Nitro-Mekatronik/Emulators_2024/Firmware/STM32F103/Emulators/ESL/BLE_UniEmulator_BMW_E60_E87_E90_5Ser/Note.txt

BMW Steering Lock Emulator

3-Series : BMW E60, BMW E61, BMW E62, BMW E63, BMW E64

5-Series : BMW E81, BMW E87, BMW E90, BMW E92, BMW E93

Mini Cooper : R55, R56
