Nitro-Mekatronik/Emulators_2024/Firmware/STM32F103/Emulators/ESL/BLE_UniEmulator_Chrysler/Note.txt

For CHRYSLER cars with Marquardt SCL (green connector) and SKREEM or WIN on board, 
designed by Daimler – Chrysler group and used on Voyager, 300, some Lancia etc…, 
usually up to 2011.

Test OK
