Nitro-Mekatronik/Emulators_2024/Firmware/STM32F103/Emulators/ESL/BLE_UniEmulator_BMW_E60_E87_E90_5Ser/Log/bmw e90 esl elv/fotograflar/WhatsApp Image 2021-02-11 at 14.41.08 (3).jpeg

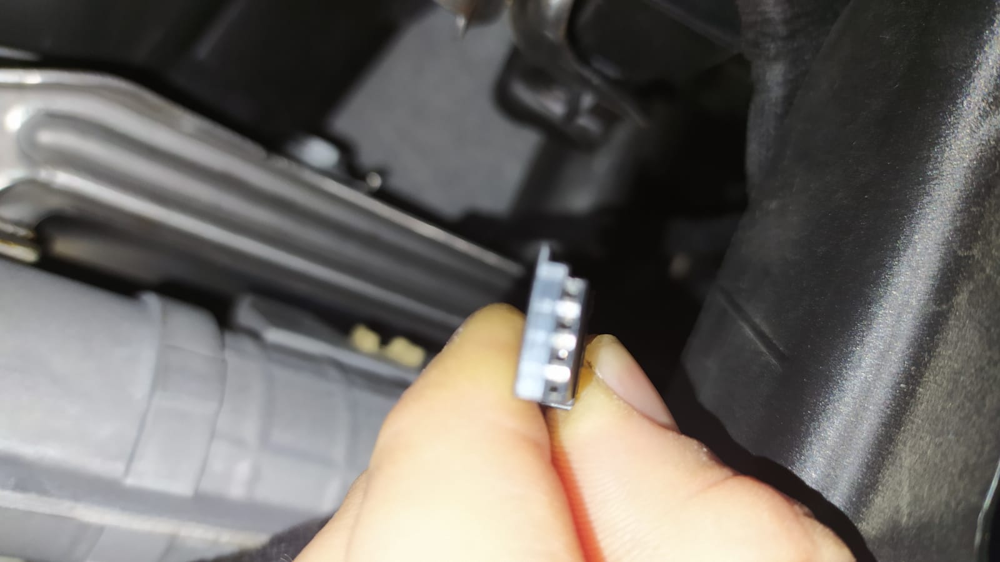
Firmware/STM32F103/Emulators/ESL/BLE_UniEmulator_BMW_E60_E87_E90_5Ser/Log/bmw e90 esl elv/fotograflar/WhatsApp Image 2021-02-11 at 14.41.08 (3).jpeg
