Nitro-Mekatronik/Emulators_2024/Firmware/STM32F103/Emulators/ESL/BLE_UniEmulator_Chrysler/Log/LIN Analyser.png

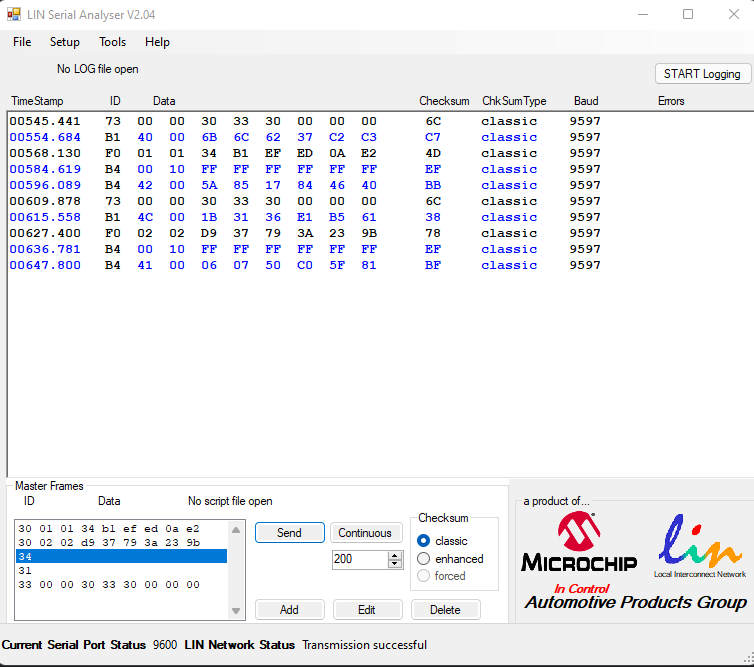
Firmware/STM32F103/Emulators/ESL/BLE_UniEmulator_Chrysler/Log/LIN Analyser.png
