Nitro-Mekatronik/Emulators_2024/Firmware/STM32F103/Emulators/ESL/BLE_UniEmulator_Volvo_S40/Log/Screenshot 2022-04-19 150752.png

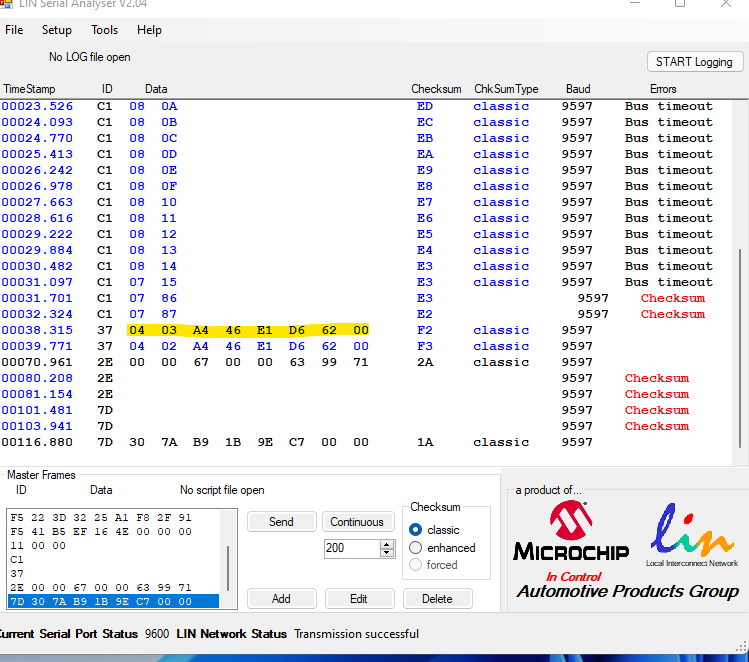
Firmware/STM32F103/Emulators/ESL/BLE_UniEmulator_Volvo_S40/Log/Screenshot 2022-04-19 150752.png
