Nitro-Mekatronik/Emulators_2024/Hardware/Arduino_Emulator New/Arduino_Emulator.xlsm

Ref | Qnty | Value | Footprint | Description | Vendor
C1, C2, C3, C10, C12, C13, C14, | 7 | 100nF 50V | C_0603 | Unpolarized capacitor, small symbol
C4, | 1 | 150pF 50V | C_0603 | Unpolarized capacitor, small symbol
C5, | 1 | 22uF 35V | C_1206 | Unpolarized capacitor, small symbol
C6, C9, | 2 | 22uF 10V | C_0805 | Unpolarized capacitor, small symbol
C7, | 1 | 10uF 10V | C_EIA-3216 | Polarized capacitor
D1, D4, | 2 | SS34 | D_SMA | Schottky diode, small symbol
D2, | 1 | LED | LED_0603 | Light emitting diode
D3, | 1 | SMAJ33A | D_SMA | Bidirectional transient-voltage-suppression diode
L1, L3, | 2 | 220R | L_0603 | Ferrite_Bead Inductor 220 Ohm @ 100MHz
L2, | 1 | CD32-100K | L_3.5mm_3mm | Inductor
R1, R7, | 2 | 10K | R_0603 | Resistor, small symbol
R2, | 1 | 5.1K | R_0603 | Resistor, small symbol
R3, | 1 | 27K | R_0603 | Resistor, small symbol
R4, | 1 | 1K | R_0603 | Resistor, small symbol
R5, | 1 | 120R | R_0805 | Resistor, small symbol
R6, | 1 | 0R | R_0603 | Resistor, small symbol
R8, R10, | 2 | 100K | R_0603 | Resistor, small symbol
R9, | 1 | 200K | R_0603 | Resistor, small symbol
U1, | 1 | ATmega328P-AU | TQFP-32_7x7mm_P0.8mm
U2, | 1 | MCP2515 | SOIC-18W_7.5x11.6mm_P1.27mm
U3, | 1 | MP2467 | TI_SO-PowerPAD-8
U4, | 1 | TJA1050T | SOIC-8_3.9x4.9mm_P1.27mm | High-Speed CAN Transceiver, silent mode, SOIC-8
Y1, Y2, | 2 | 8MHZ | Resonator_SMD_muRata_CSTxExxV-3Pin_3.0x1.1mm | Three pin crystal, GND on pin 2
