Nitro-Mekatronik/Emulators_2024/Hardware/NTR-MAIN-U2xx/NTR-MAIN-U2xx.kicad_pcb

## KiCad design Hardware/NTR-MAIN-U2xx/NTR-MAIN-U2xx.kicad_pcb (2025-08-07)

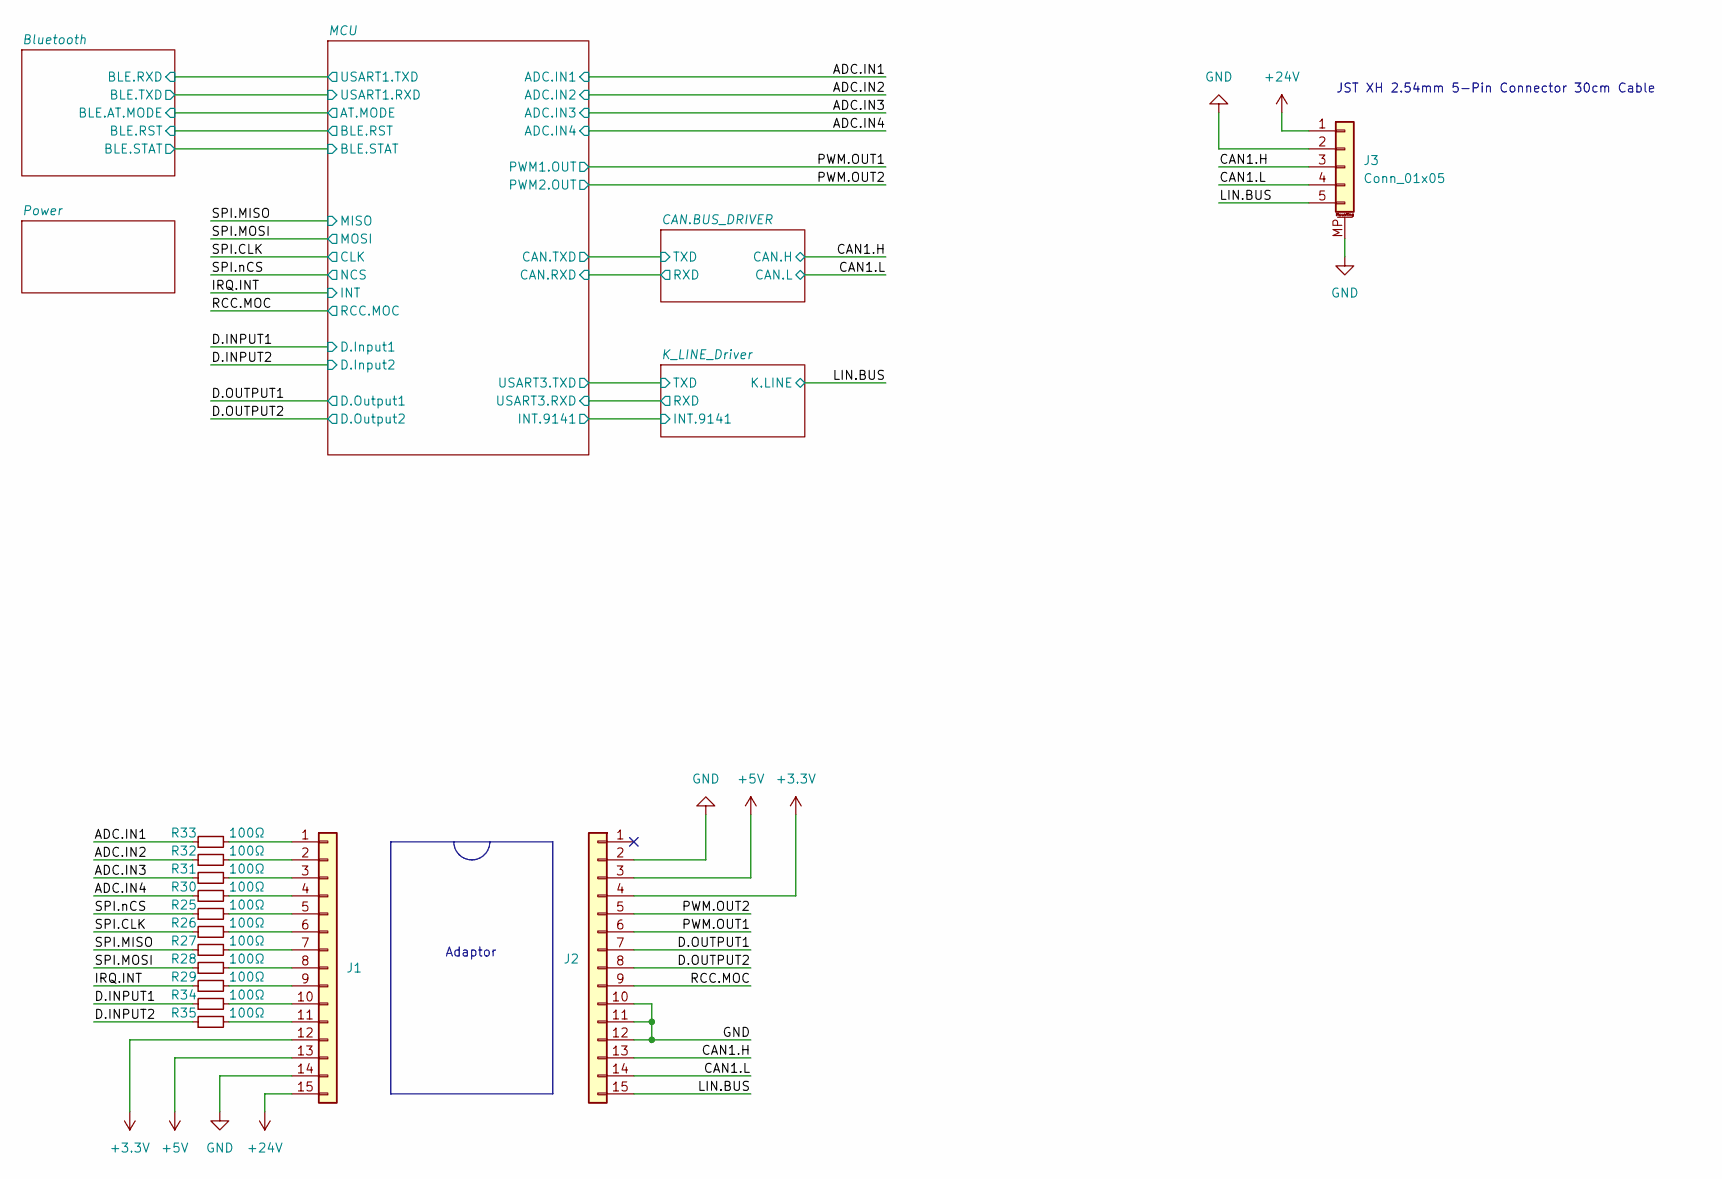
[picture p9: schematic NTR-MAIN-U2xx.kicad_sch]

Parts:
J1, J2: Conn_01x15; PinSocket_1x15_P2.54mm_Vertical; LCSC C2897378
J3: Conn_01x05; Molex_PicoBlade_53261-0571_1x05-1MP_P1.25mm_Horizontal; LCSC C481427
R25, R26, R27, R28, R29, R30, R31, R32, R33, R34, R35: 100Ω; R_0402_1005Metric; LCSC C25076

Connections:
+3.3V: J1.12, J2.4; also elsewhere on the board
+5V: J1.13, J2.3; also elsewhere on the board
+24V: J1.15, J3.1; also elsewhere on the board
/ADC.IN1: R33.1; also elsewhere on the board
/ADC.IN2: R32.1; also elsewhere on the board
/ADC.IN3: R31.1; also elsewhere on the board
/ADC.IN4: R30.1; also elsewhere on the board
/CAN1.H: J2.13, J3.3; also elsewhere on the board
/CAN1.L: J2.14, J3.4; also elsewhere on the board
/D.INPUT1: R34.1; also elsewhere on the board
/D.INPUT2: R35.1; also elsewhere on the board
/D.OUTPUT1: J2.7; also elsewhere on the board
/D.OUTPUT2: J2.8; also elsewhere on the board
/IRQ.INT: R29.1; also elsewhere on the board
/LIN.BUS: J2.15, J3.5; also elsewhere on the board
/PWM.OUT1: J2.6; also elsewhere on the board
/PWM.OUT2: J2.5; also elsewhere on the board
/RCC.MOC: J2.9; also elsewhere on the board
/SPI.CLK: R26.1; also elsewhere on the board
/SPI.MISO: R27.1; also elsewhere on the board
/SPI.MOSI: R28.1; also elsewhere on the board
/SPI.nCS: R25.1; also elsewhere on the board
GND: J1.14, J2.2, J2.10, J2.11, J2.12, J3.2, J3.MP (MountPin); also elsewhere on the board
unnamed: J1.1, R33.2
unnamed: J1.2, R32.2
unnamed: J1.3, R31.2
unnamed: J1.4, R30.2
unnamed: J1.5, R25.2
unnamed: J1.6, R26.2
unnamed: J1.7, R27.2
unnamed: J1.8, R28.2
unnamed: J1.9, R29.2
unnamed: J1.10, R34.2
unnamed: J1.11, R35.2

Notes on the sheet:
Adaptor
JST XH 2.54mm 5-Pin Connector 30cm Cable

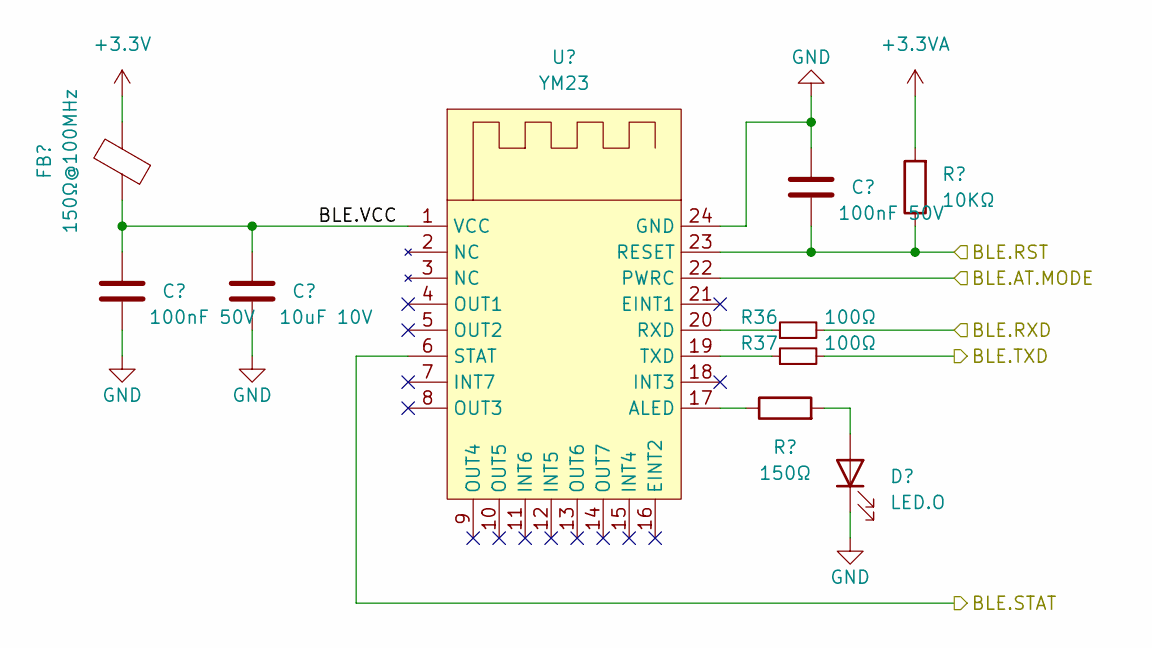
[picture p10: schematic Bluetooth.kicad_sch]

Parts:
C8, C10: 100nF 50V; C_0402_1005Metric; LCSC C77020
C9: 10uF 10V; C_0402_1005Metric; LCSC C315248
D4: LED.O; LED_0402_1005Metric; LCSC C434447
FB1: 150Ω@100MHz; L_0402_1005Metric; LCSC C160612
R15: 150Ω; R_0402_1005Metric; LCSC C25082
R16: 10KΩ; R_0402_1005Metric; LCSC C25744
R36, R37: 100Ω; R_0402_1005Metric; LCSC C25076
U4: YM23; JDY-08; LCSC C2905738

Connections:
+3.3V: FB1.2; also elsewhere on the board
+3.3VA: R16.2; also elsewhere on the board
/Bluetooth/BLE.AT.MODE: U4.22 (PWRC); also elsewhere on the board
/Bluetooth/BLE.RST: C10.2, R16.1, U4.23 (RESET); also elsewhere on the board
/Bluetooth/BLE.RXD: R36.2; also elsewhere on the board
/Bluetooth/BLE.STAT: U4.6 (STAT); also elsewhere on the board
/Bluetooth/BLE.TXD: R37.2; also elsewhere on the board
/Bluetooth/BLE.VCC: C8.1, C9.1, FB1.1, U4.1 (VCC)
GND: C8.2, C9.2, C10.1, D4.1 (K), U4.24 (GND); also elsewhere on the board
unnamed: D4.2 (A), R15.2
unnamed: R15.1, U4.17 (ALED)
unnamed: R36.1, U4.20 (RXD)
unnamed: R37.1, U4.19 (TXD)

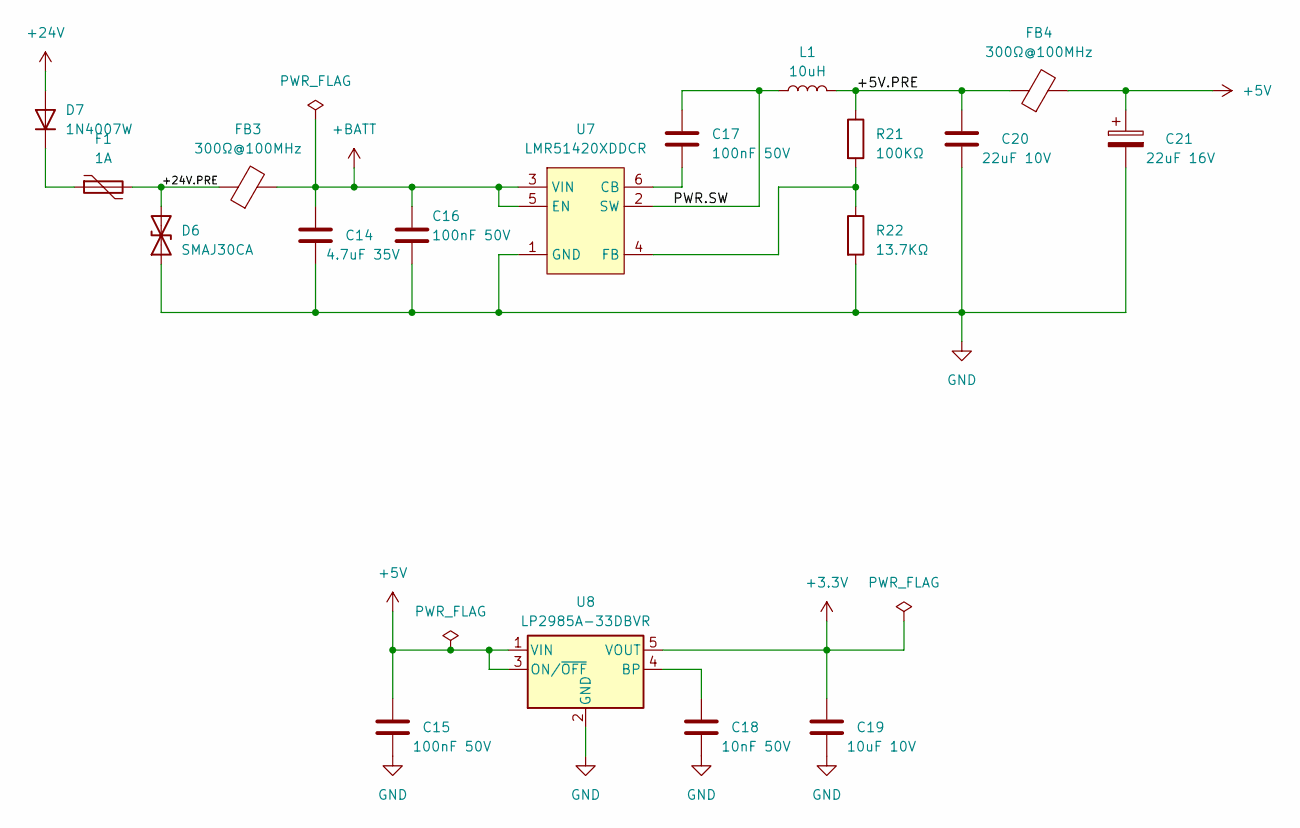
[picture p11: schematic Power.kicad_sch]

Parts:
C14: 4.7uF 35V; C_0603_1608Metric; LCSC C162274
C15, C16, C17: 100nF 50V; C_0402_1005Metric; LCSC C77020
C18: 10nF 50V; C_0402_1005Metric; LCSC C15195
C19: 10uF 10V; C_0402_1005Metric; LCSC C315248
C20: 22uF 10V; C_0805_2012Metric; LCSC C380336
C21: 22uF 16V; CP_EIA-3216-10_Kemet-I; LCSC C782264
D6: SMAJ30CA; D_SMA; LCSC C356367
D7: 1N4007W; D_SOD-123; LCSC C3018540
F1: 1A; Fuse_1812_4532Metric; LCSC C782762
FB3: 300Ω@100MHz; L_0603_1608Metric; LCSC C401489
FB4: 300Ω@100MHz; L_0805_2012Metric; LCSC C67451
L1: 10uH; L_Bourns-SRN4018; LCSC C135244
R21: 100KΩ; R_0402_1005Metric; LCSC C25741
R22: 13.7KΩ; R_0402_1005Metric; LCSC C25854
U7: LMR51420XDDCR; SOT-23-6; LCSC C5246146
U8: LP2985A-33DBVR; SOT-23-5; LCSC C89826

Connections:
+3.3V: C19.1, U8.5 (VOUT); also elsewhere on the board
+5V: C15.1, C21.1, FB4.2, U8.1 (VIN), U8.3 (ON/~OFF); also elsewhere on the board
+24V: D7.2 (A); also elsewhere on the board
+BATT: C14.1, C16.1, FB3.2, U7.3 (VIN), U7.5 (EN); also elsewhere on the board
/Power/+5V.PRE: C20.1, FB4.1, L1.2, R21.1
/Power/+24V.PRE: D6.2 (A2), F1.2, FB3.1
/Power/PWR.SW: C17.1, L1.1, U7.2 (SW)
GND: C14.2, C15.2, C16.2, C18.2, C19.2, C20.2, C21.2, D6.1 (A1), R22.2, U7.1 (GND), U8.2 (GND); also elsewhere on the board
unnamed: D7.1 (K), F1.1
unnamed: C17.2, U7.6 (CB)
unnamed: R21.2, R22.1, U7.4 (FB)
unnamed: C18.1, U8.4 (BP)

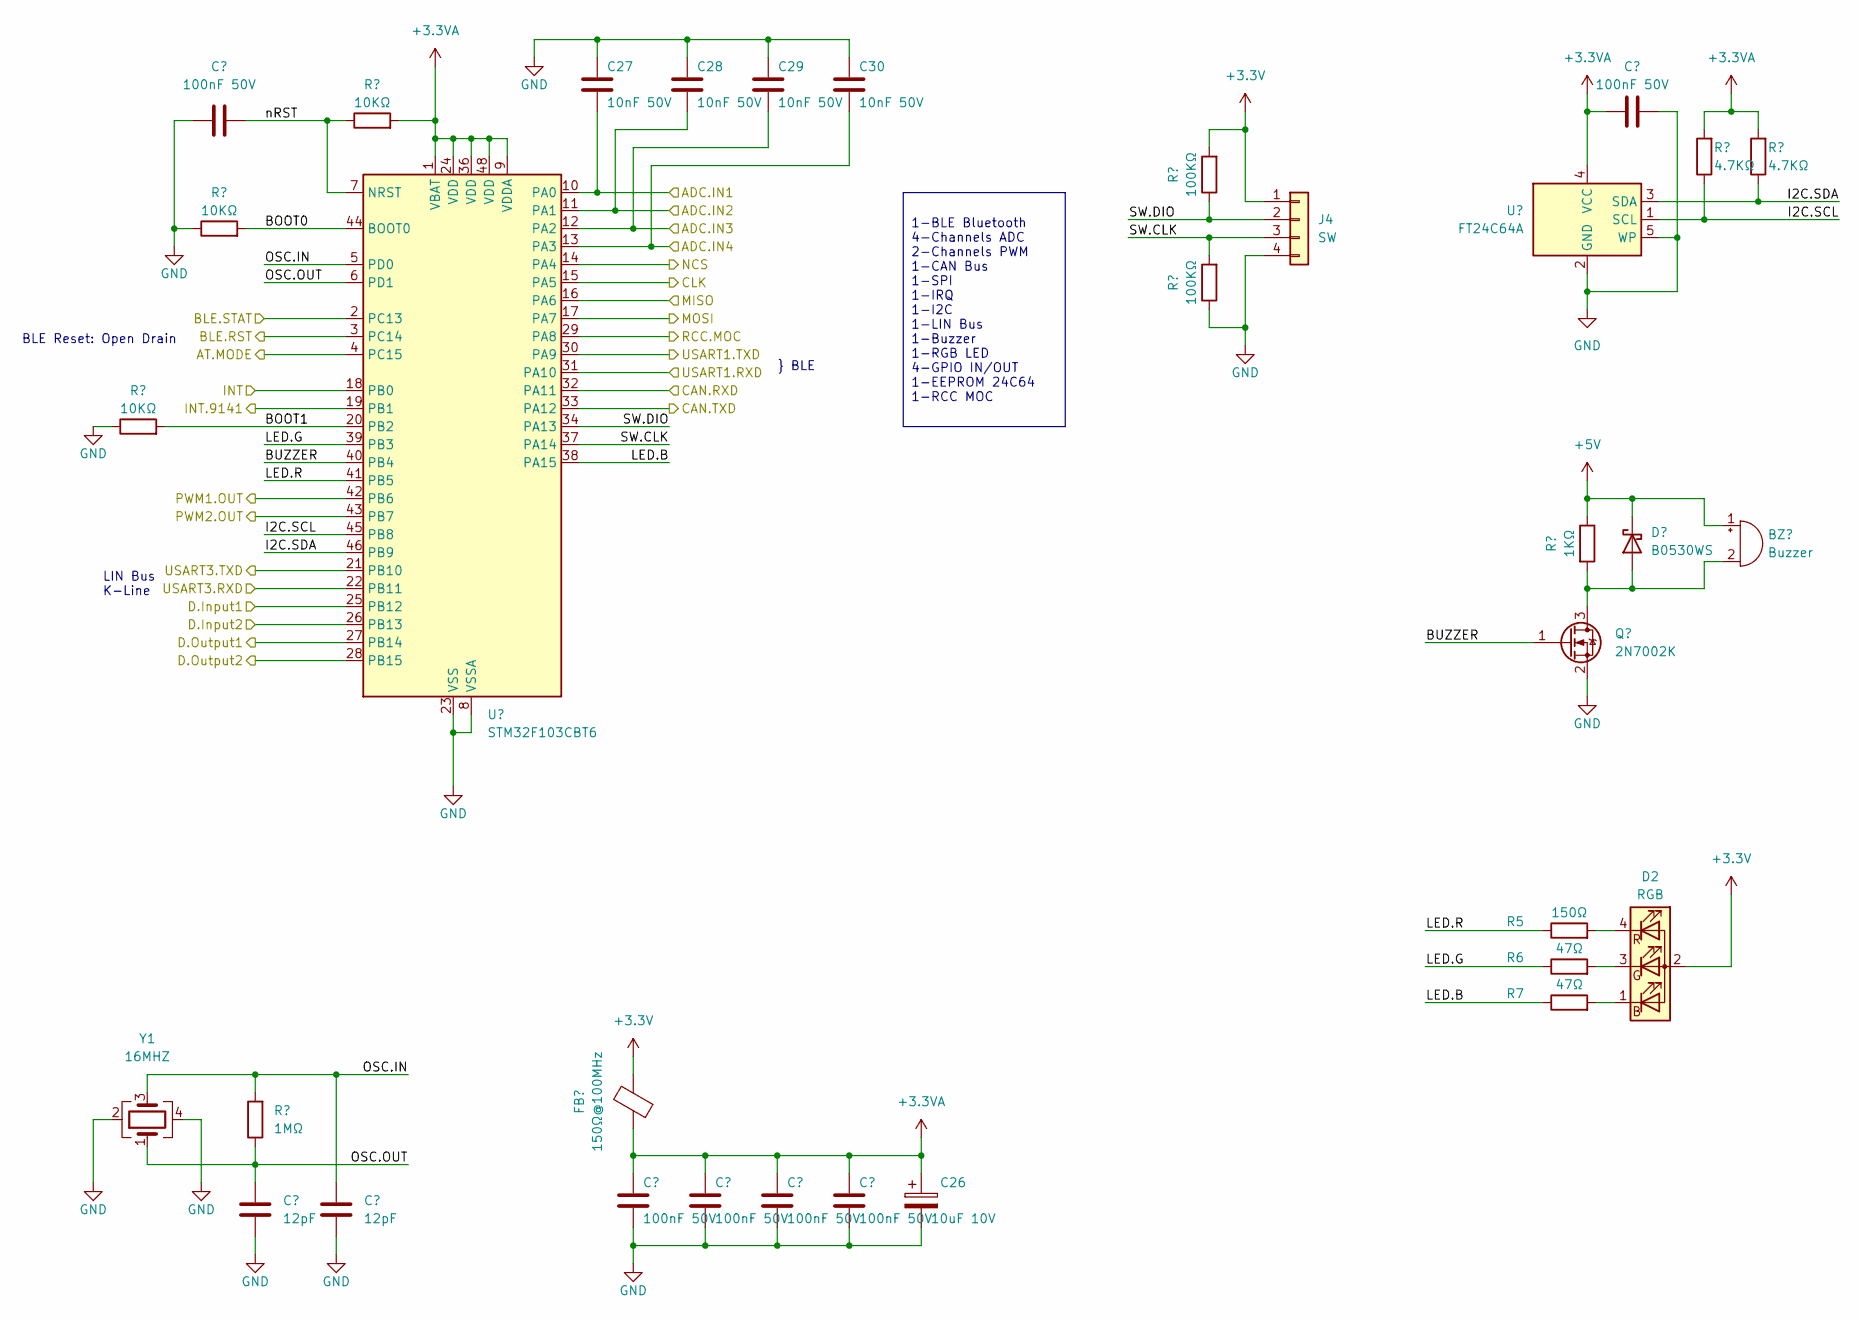
[picture p12: schematic mcu.kicad_sch]

Parts:
BZ1: Buzzer; MagneticBuzzer_CUI_CMT-8504-100-SMT; LCSC C255315
C1, C4, C22, C23, C24, C25: 100nF 50V; C_0402_1005Metric; LCSC C77020
C2, C3: 12pF; C_0402_1005Metric; LCSC C76948
C26: 10uF 10V; CP_EIA-3216-10_Kemet-I; LCSC C7177
C27, C28, C29, C30: 10nF 50V; C_0402_1005Metric; LCSC C15195
D1: B0530WS; D_SOD-323; LCSC C2961213
D2: RGB; LED_Cree-PLCC4_2x2mm_CW; LCSC C375569
FB5: 150Ω@100MHz; L_0402_1005Metric; LCSC C160612
J4: SW; PinHeader_1x04_P2.54mm_Vertical
Q1: 2N7002K; SOT-23; LCSC C2848187
R1, R2, R4: 10KΩ; R_0402_1005Metric; LCSC C25744
R3: 1MΩ; R_0402_1005Metric; LCSC C138033
R5: 150Ω; R_0402_1005Metric; LCSC C25082
R6, R7: 47Ω; R_0402_1005Metric; LCSC C25168
R8: 1KΩ; R_0402_1005Metric; LCSC C11702
R9, R10: 4.7KΩ; R_0402_1005Metric; LCSC C25900
R23, R24: 100KΩ; R_0402_1005Metric; LCSC C25741
U1: STM32F103CBT6; LQFP-48_7x7mm_P0.5mm; LCSC C8304
U2: FT24C64A; SOT-23-5; LCSC C5263778
Y1: 16MHZ; Crystal_SMD_2520-4Pin_2.5x2.0mm; LCSC C13738

Connections:
+3.3V: D2.2 (A), FB5.2, J4.1, R23.2; also elsewhere on the board
+3.3VA: C4.1, C22.2, C23.2, C24.2, C25.2, C26.1, FB5.1, R4.2, R9.2, R10.2, U1.1 (VBAT), U1.9 (VDDA), U1.24 (VDD), U1.36 (VDD), U1.48 (VDD), U2.4 (VCC); also elsewhere on the board
+5V: BZ1.1 (-), D1.1 (K), R8.1; also elsewhere on the board
/ADC.IN1: C27.2, U1.10 (PA0); also elsewhere on the board
/ADC.IN2: C28.2, U1.11 (PA1); also elsewhere on the board
/ADC.IN3: C29.2, U1.12 (PA2); also elsewhere on the board
/ADC.IN4: C30.2, U1.13 (PA3); also elsewhere on the board
/Bluetooth/BLE.AT.MODE: U1.4 (PC15); also elsewhere on the board
/Bluetooth/BLE.RST: U1.3 (PC14); also elsewhere on the board
/Bluetooth/BLE.RXD: U1.30 (PA9); also elsewhere on the board
/Bluetooth/BLE.STAT: U1.2 (PC13); also elsewhere on the board
/Bluetooth/BLE.TXD: U1.31 (PA10); also elsewhere on the board
/CAN.BUS_DRIVER/RXD: U1.32 (PA11); also elsewhere on the board
/CAN.BUS_DRIVER/TXD: U1.33 (PA12); also elsewhere on the board
/D.INPUT1: U1.25 (PB12); also elsewhere on the board
/D.INPUT2: U1.26 (PB13); also elsewhere on the board
/D.OUTPUT1: U1.27 (PB14); also elsewhere on the board
/D.OUTPUT2: U1.28 (PB15); also elsewhere on the board
/IRQ.INT: U1.18 (PB0); also elsewhere on the board
/K_LINE_Driver/INT.9141: U1.19 (PB1); also elsewhere on the board
/K_LINE_Driver/RXD: U1.22 (PB11); also elsewhere on the board
/K_LINE_Driver/TXD: U1.21 (PB10); also elsewhere on the board
/MCU/BOOT0: R2.2, U1.44 (BOOT0)
/MCU/BOOT1: R1.2, U1.20 (PB2)
/MCU/BUZZER: Q1.1 (G), U1.40 (PB4)
/MCU/I2C.SCL: R9.1, U1.45 (PB8), U2.1 (SCL)
/MCU/I2C.SDA: R10.1, U1.46 (PB9), U2.3 (SDA)
/MCU/LED.B: R7.1, U1.38 (PA15)
/MCU/LED.G: R6.1, U1.39 (PB3)
/MCU/LED.R: R5.1, U1.41 (PB5)
/MCU/OSC.IN: C3.1, R3.2, U1.5 (PD0), Y1.3
/MCU/OSC.OUT: C2.1, R3.1, U1.6 (PD1), Y1.1
/MCU/SW.CLK: J4.3, R24.2, U1.37 (PA14)
/MCU/SW.DIO: J4.2, R23.1, U1.34 (PA13)
/MCU/nRST: C1.2, R4.1, U1.7 (NRST)
/PWM.OUT1: U1.42 (PB6); also elsewhere on the board
/PWM.OUT2: U1.43 (PB7); also elsewhere on the board
/RCC.MOC: U1.29 (PA8); also elsewhere on the board
/SPI.CLK: U1.15 (PA5); also elsewhere on the board
/SPI.MISO: U1.16 (PA6); also elsewhere on the board
/SPI.MOSI: U1.17 (PA7); also elsewhere on the board
/SPI.nCS: U1.14 (PA4); also elsewhere on the board
GND: C1.1, C2.2, C3.2, C4.2, C22.1, C23.1, C24.1, C25.1, C26.2, C27.1, C28.1, C29.1, C30.1, J4.4, Q1.2 (S), R1.1, R2.1, R24.1, U1.8 (VSSA), U1.23 (VSS), U1.35 (VSS), U1.47 (VSS), U2.2 (GND), U2.5 (WP), Y1.2, Y1.4; also elsewhere on the board
unnamed: BZ1.2 (+), D1.2 (A), Q1.3 (D), R8.2
unnamed: D2.1 (BK), R7.2
unnamed: D2.3 (GK), R6.2
unnamed: D2.4 (RK), R5.2

Notes on the sheet:
1-BLE Bluetooth 4-Channels ADC 2-Channels PWM 1-CAN Bus 1-SPI 1-IRQ 1-I2C 1-LIN Bus 1-Buzzer 1-RGB LED 4-GPIO IN/OUT 1-EEPROM 24C64 1-RCC MOC
LIN Bus K-Line
BLE Reset: Open Drain
} BLE

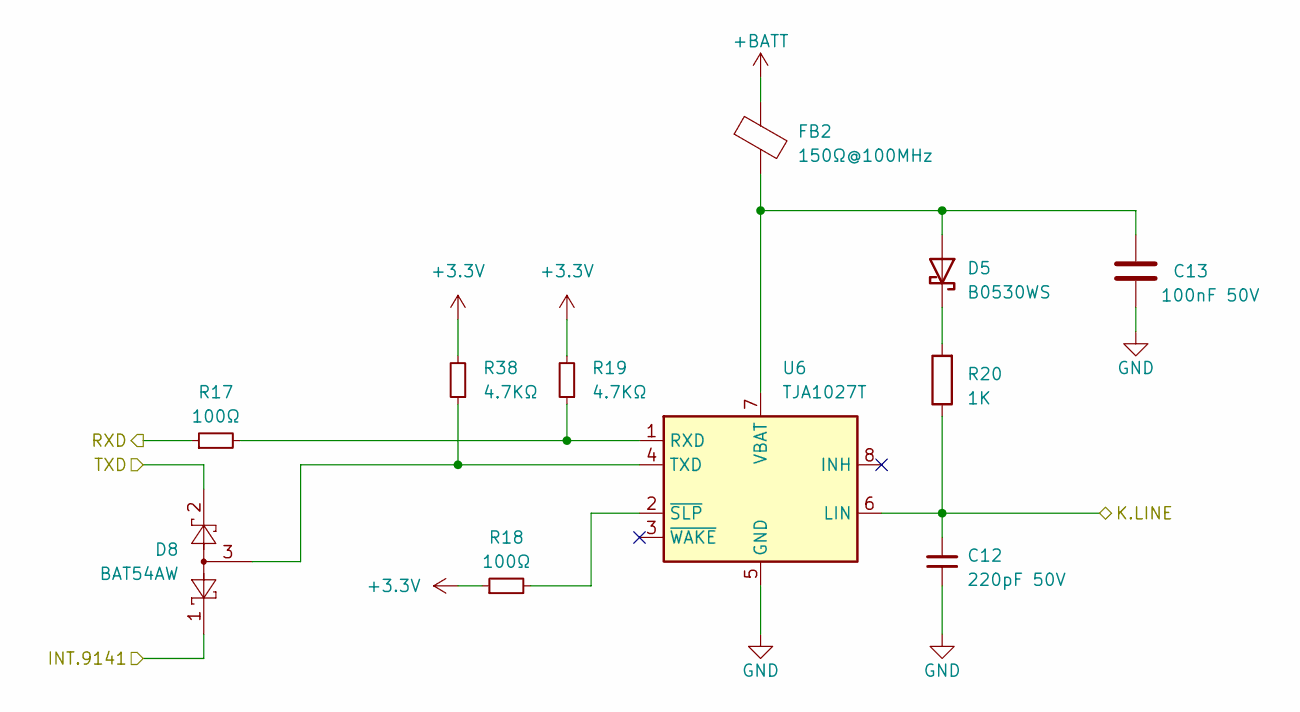
[picture p13: schematic K_LINE_Driver.kicad_sch]

Parts:
C12: 220pF 50V; C_0402_1005Metric; LCSC C107025
C13: 100nF 50V; C_0402_1005Metric; LCSC C77020
D5: B0530WS; D_SOD-323; LCSC C2961213
D8: BAT54AW; SOT-323_SC-70; LCSC C890244
FB2: 150Ω@100MHz; L_0402_1005Metric; LCSC C160612
R17, R18: 100Ω; R_0402_1005Metric; LCSC C25076
R19, R38: 4.7KΩ; R_0402_1005Metric; LCSC C25900
R20: 1K; R_0603_1608Metric; LCSC C21190
U6: TJA1027T; SO-8_3.9x4.9mm_P1.27mm; LCSC C194371

Connections:
+3.3V: R18.1, R19.2, R38.2; also elsewhere on the board
+BATT: FB2.1; also elsewhere on the board
/K_LINE_Driver/INT.9141: D8.1; also elsewhere on the board
/K_LINE_Driver/RXD: R17.1; also elsewhere on the board
/K_LINE_Driver/TXD: D8.2; also elsewhere on the board
/LIN.BUS: C12.2, R20.1, U6.6 (LIN); also elsewhere on the board
GND: C12.1, C13.2, U6.5 (GND); also elsewhere on the board
unnamed: C13.1, D5.2 (A), FB2.2, U6.7 (VBAT)
unnamed: D5.1 (K), R20.2
unnamed: R17.2, R19.1, U6.1 (RXD)
unnamed: D8.3, R38.1, U6.4 (TXD)
unnamed: R18.2, U6.2 (~SLP)

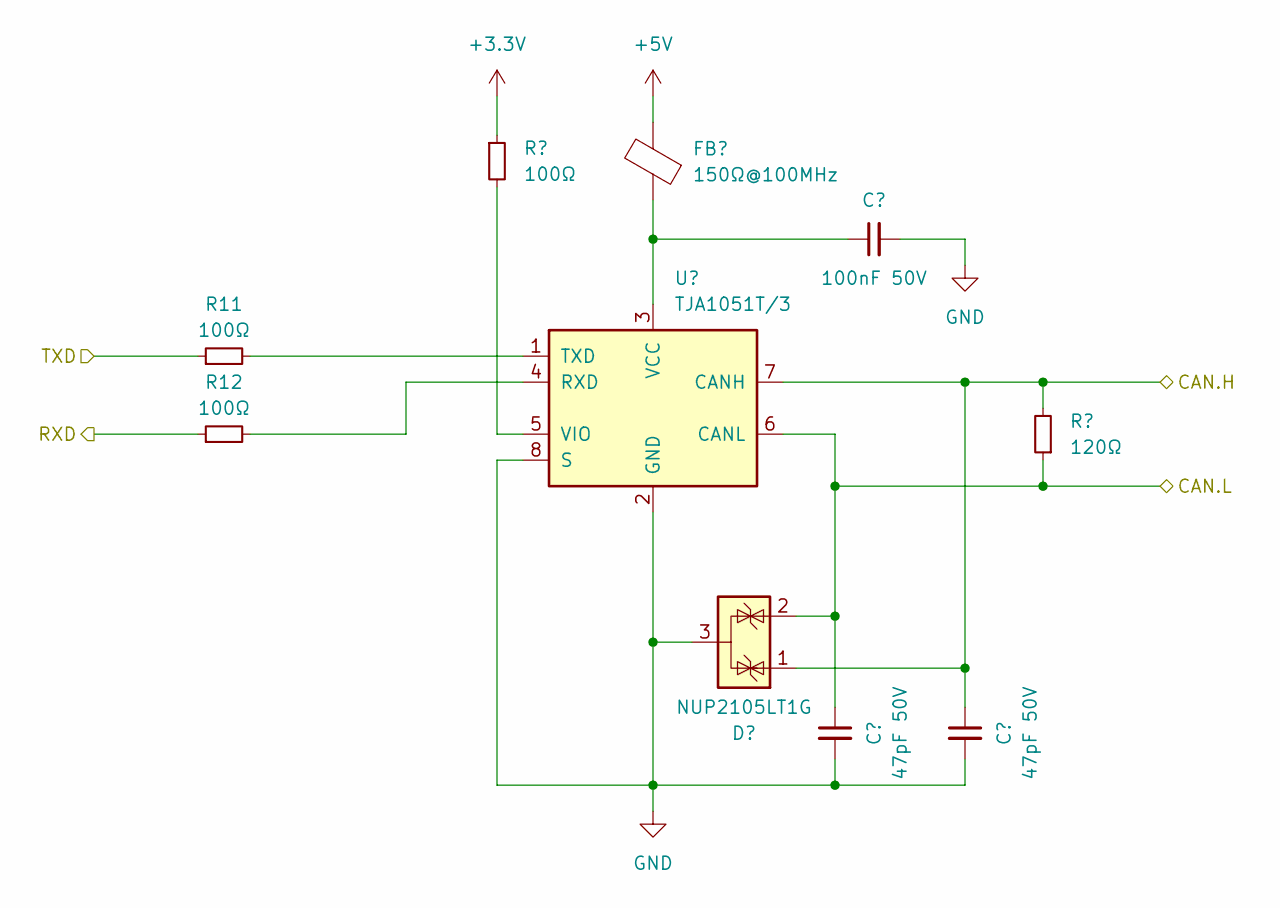
[picture p14: schematic CAN.BUS_DRIVER.kicad_sch]

Parts:
C5: 100nF 50V; C_0402_1005Metric; LCSC C77020
C6, C7: 47pF 50V; C_0402_1005Metric; LCSC C76970
D3: NUP2105LT1G; SOT-23; LCSC C2890118
FB6: 150Ω@100MHz; L_0402_1005Metric; LCSC C160612
R11, R12, R13: 100Ω; R_0402_1005Metric; LCSC C25076
R14: 120Ω; R_0805_2012Metric; LCSC C17437
U3: TJA1051T/3; SOIC-8_3.9x4.9mm_P1.27mm; LCSC C5342108

Connections:
+3.3V: R13.1; also elsewhere on the board
+5V: FB6.2; also elsewhere on the board
/CAN1.H: C7.1, D3.1 (K), R14.2, U3.7 (CANH); also elsewhere on the board
/CAN1.L: C6.1, D3.2 (K), R14.1, U3.6 (CANL); also elsewhere on the board
/CAN.BUS_DRIVER/RXD: R12.1; also elsewhere on the board
/CAN.BUS_DRIVER/TXD: R11.1; also elsewhere on the board
GND: C5.2, C6.2, C7.2, D3.3 (A), U3.2 (GND), U3.8 (S); also elsewhere on the board
unnamed: R12.2, U3.4 (RXD)
unnamed: R11.2, U3.1 (TXD)
unnamed: C5.1, FB6.1, U3.3 (VCC)
unnamed: R13.2, U3.5 (VIO)

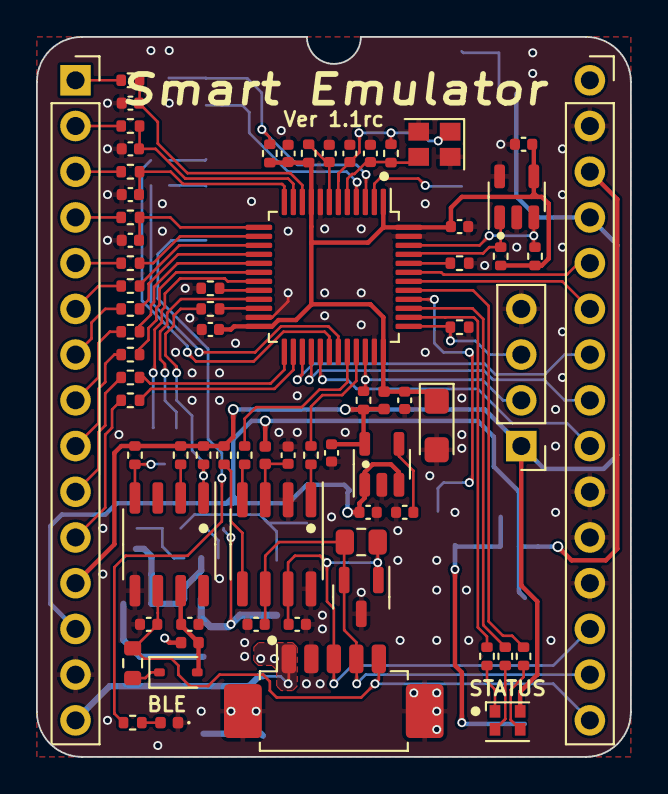
[picture p15: board NTR-MAIN-U2xx.kicad_pcb from above]

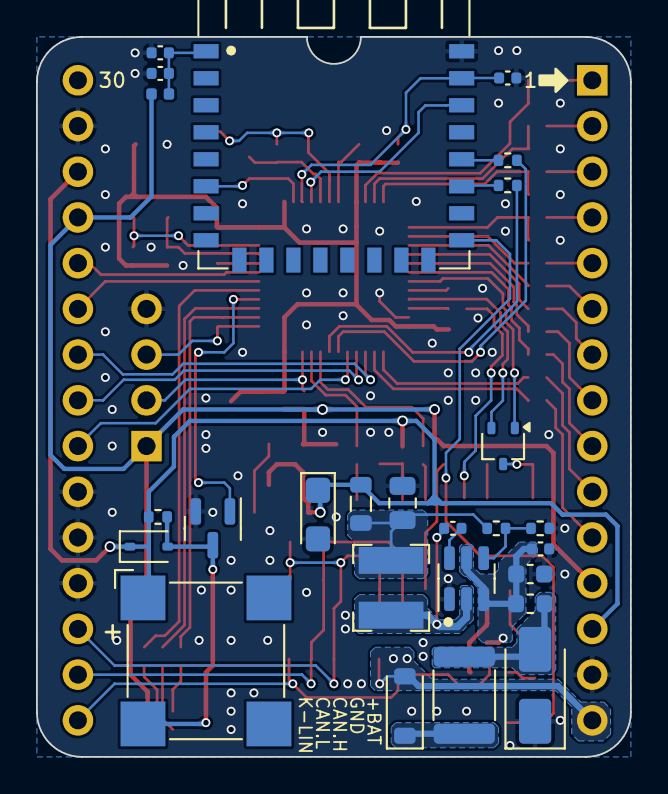
[picture p16: board NTR-MAIN-U2xx.kicad_pcb from below]

Board: 2 copper layers, 33.0 x 40.0 mm, 97 parts (26 on the bottom side), 84 nets.
