Nitro-Mekatronik/Emulators_2024/Hardware/Arduino_Emulator New/Arduino_Emulator.kicad_pcb

## KiCad design Hardware/Arduino_Emulator New/Arduino_Emulator.kicad_pcb (2025-08-07)

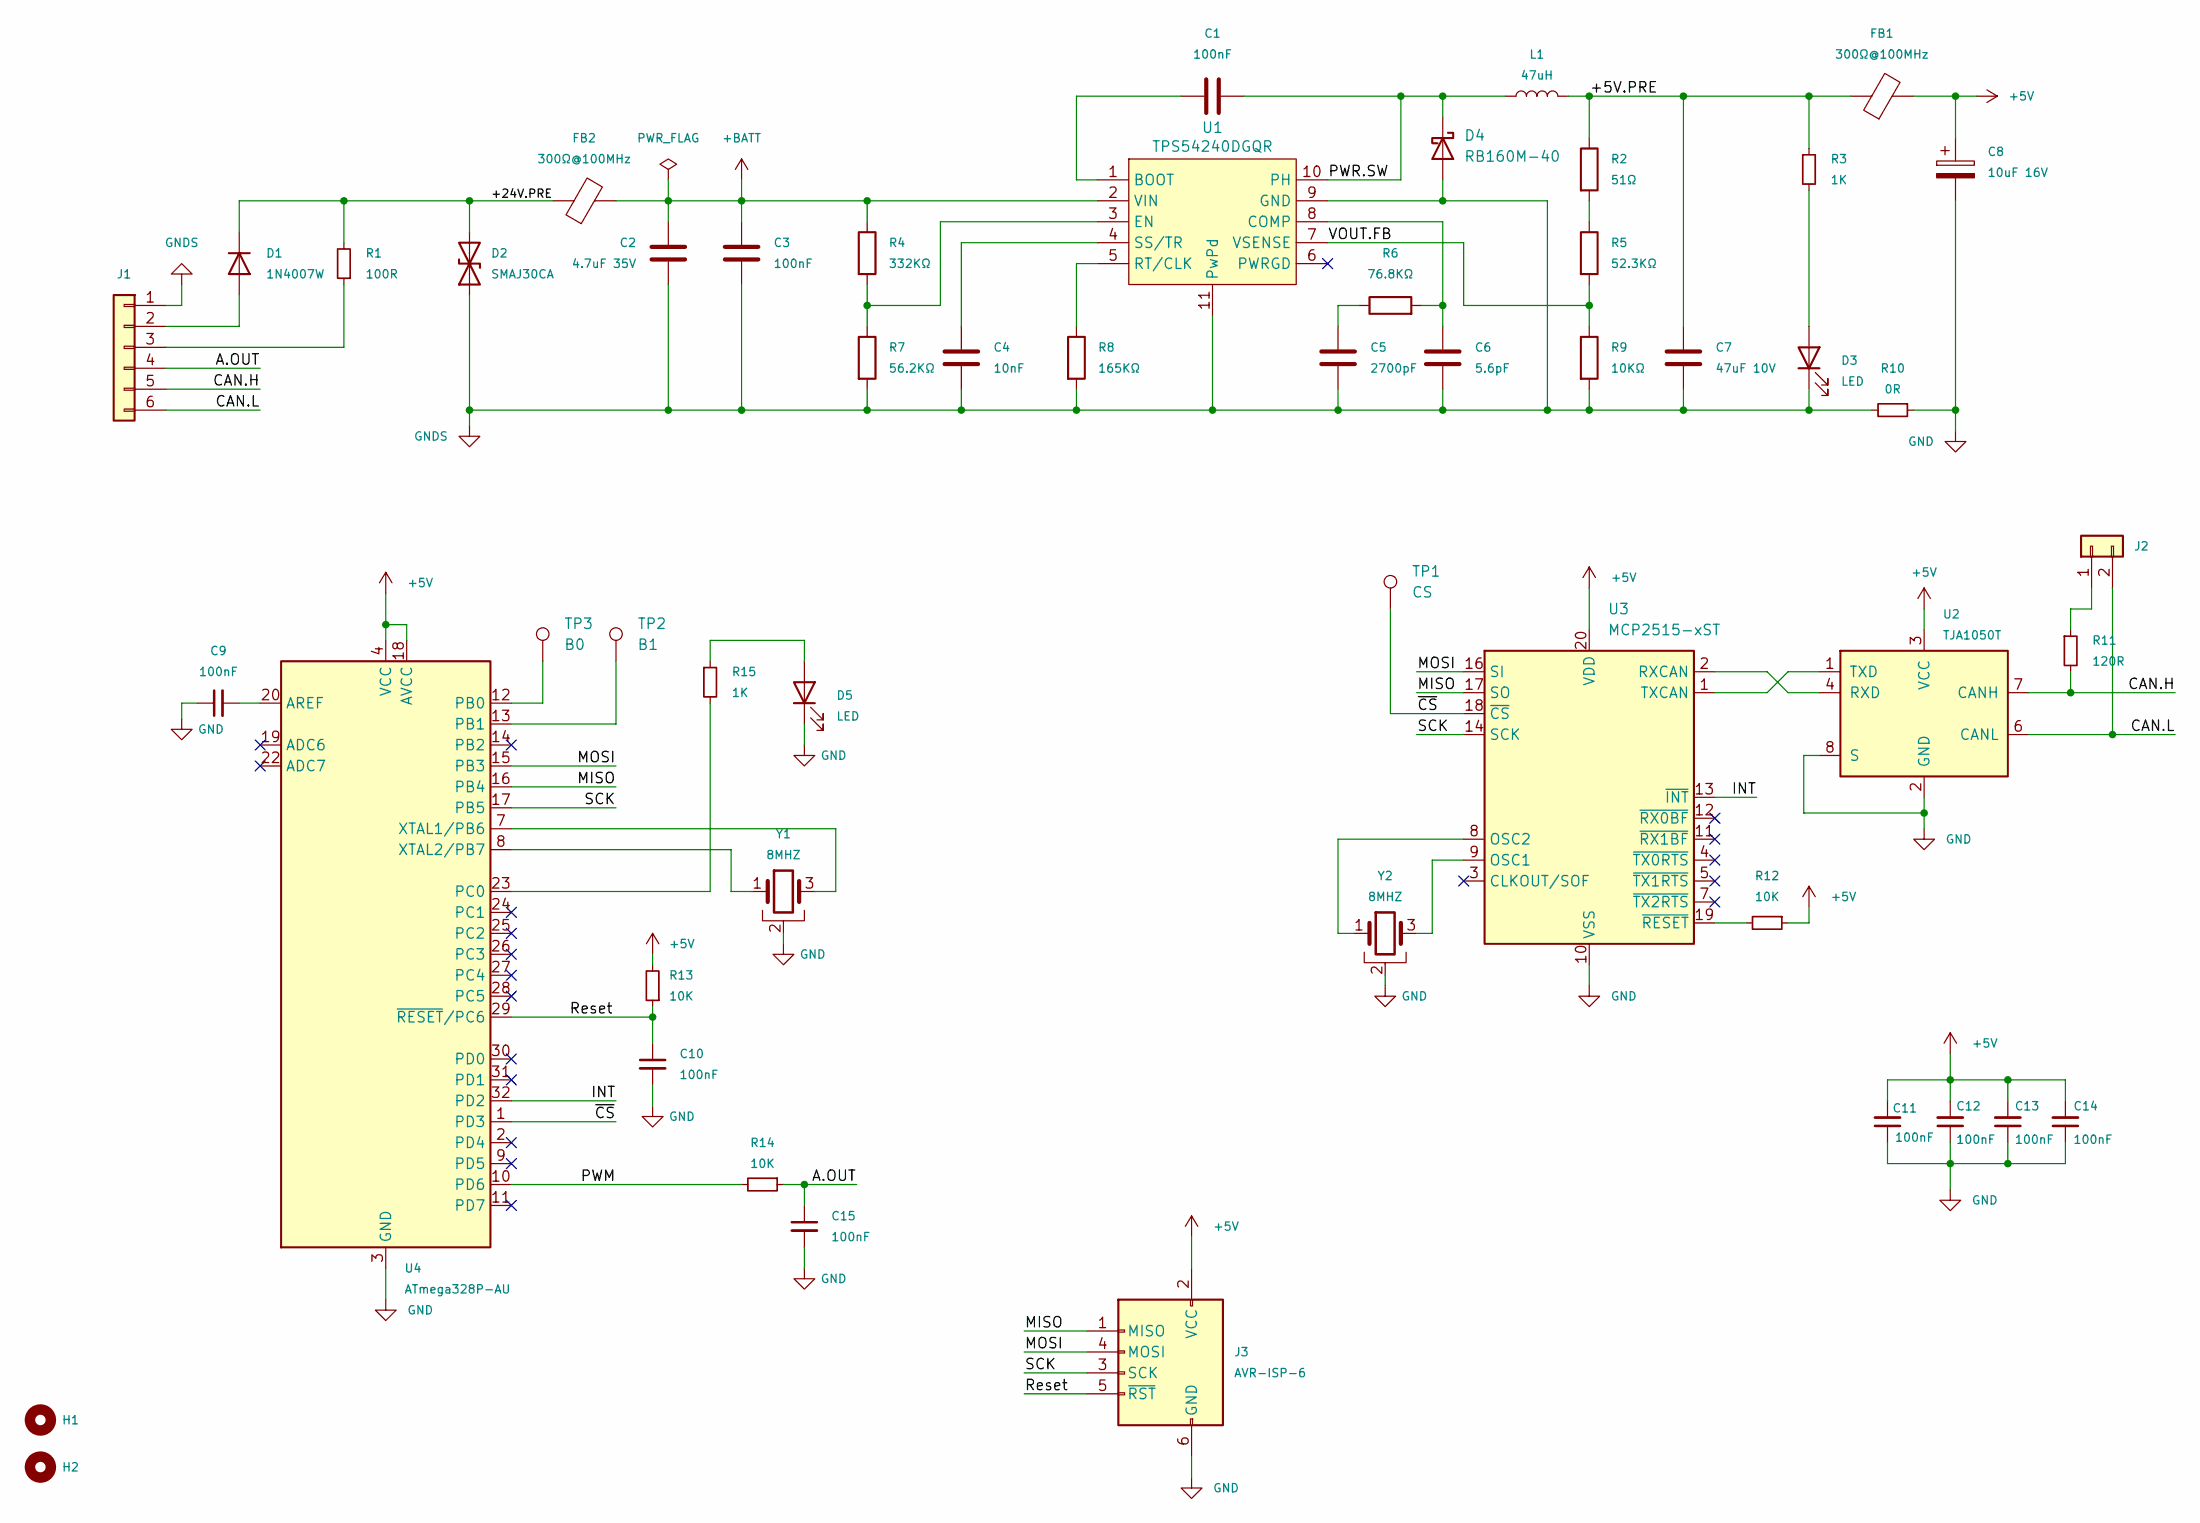
[picture p17: schematic Arduino_Emulator.kicad_sch]

Parts:
C1, C3, C9, C10, C11, C12, C13, C14, C15: 100nF; C_0402_1005Metric; LCSC C77020
C2: 4.7uF 35V; C_0603_1608Metric; LCSC C162274
C4: 10nF; C_0402_1005Metric; LCSC C386111
C5: 2700pF; C_0402_1005Metric; LCSC C162193
C6: 5.6pF; C_0402_1005Metric; LCSC C161155
C7: 47uF 10V; C_0805_2012Metric; LCSC C386058
C8: 10uF 16V; CP_EIA-3216-10_Kemet-I; LCSC C185772
D1: 1N4007W; D_SOD-123; LCSC C3018540
D2: SMAJ30CA; D_SMA; LCSC C356367
D3, D5: LED; LED_0402_1005Metric
D4: RB160M-40; D_SOD-123; LCSC C688896
FB1: 300Ω@100MHz; L_0805_2012Metric; LCSC C67451
FB2: 300Ω@100MHz; L_0603_1608Metric; LCSC C401489
H1, H2: MountingHole; MountingHole_2.5mm
J1: Conn_01x05; PinHeader_1x06_P2.54mm_Vertical
J2: Conn_01x02; SolderJumper-2_P1.3mm_Open_RoundedPad1.0x1.5mm
J3: AVR-ISP-6; PinHeader_2x03_P2.54mm_Vertical
L1: 47uH; L_Bourns-SRN4018; LCSC C341015
R1: 100R; R_0805_2012Metric; LCSC C17408
R2: 51Ω; R_0402_1005Metric; LCSC C325571
R3, R15: 1K; R_0402_1005Metric; LCSC C11702
R4: 332KΩ; R_0402_1005Metric; LCSC C321451
R5: 52.3KΩ; R_0402_1005Metric; LCSC C170333
R6: 76.8KΩ; R_0402_1005Metric; LCSC C158981
R7: 56.2KΩ; R_0402_1005Metric; LCSC C208917
R8: 165KΩ; R_0402_1005Metric; LCSC C25741
R9: 10KΩ; R_0402_1005Metric; LCSC C25854
R10: 0R; R_0402_1005Metric; LCSC C17168
R11: 120R; R_0805_2012Metric; LCSC C17437
R12, R13, R14: 10K; R_0402_1005Metric; LCSC C25744
TP1: CS; TestPoint_Pad_D1.5mm
TP2: B1; TestPoint_Pad_D1.5mm
TP3: B0; TestPoint_Pad_D1.5mm
U1: TPS54240DGQR; MSOP-10-1EP_3x3mm_P0.5mm_EP1.68x1.88mm; LCSC C53213
U2: TJA1050T; SOIC-8_3.9x4.9mm_P1.27mm; LCSC C6952
U3: MCP2515-xST; TSSOP-20_4.4x6.5mm_P0.65mm; LCSC C5250735
U4: ATmega328P-AU; TQFP-32_7x7mm_P0.8mm; LCSC C14877
Y1, Y2: 8MHZ; Resonator_SMD_muRata_CSTxExxV-3Pin_3.0x1.1mm; LCSC C22549

Connections:
+5V: C8.1, C11.2, C12.2, C13.2, C14.2, FB1.2, J3.2 (VCC), R12.1, R13.2, U2.3 (VCC), U3.20 (VDD), U4.4 (VCC), U4.6 (VCC), U4.18 (AVCC)
+BATT: C2.1, C3.1, FB2.2, R4.1, U1.2 (VIN)
/+5V.PRE: C7.1, FB1.1, L1.2, R2.1, R3.1
/+24V.PRE: D1.1 (K), D2.2 (A2), FB2.1, R1.2
/A.OUT: C15.1, J1.4, R14.1
/CAN.H: J1.5, R11.2, U2.7 (CANH)
/CAN.L: J1.6, J2.2, U2.6 (CANL)
/INT: U3.13 (~INT), U4.32 (PD2)
/MISO: J3.1 (MISO), U3.17 (SO), U4.16 (PB4)
/MOSI: J3.4 (MOSI), U3.16 (SI), U4.15 (PB3)
/PWM: R14.2, U4.10 (PD6)
/PWR.SW: C1.2, D4.1 (K), L1.1, U1.10 (PH)
/Reset: C10.1, J3.5 (~RST), R13.1, U4.29 (~RESET/PC6)
/SCK: J3.3 (SCK), U3.14 (SCK), U4.17 (PB5)
/VOUT.FB: R5.2, R9.1, U1.7 (VSENSE)
/~CS: TP1.1, U3.18 (~CS), U4.1 (PD3)
GND: C8.2, C9.1, C10.2, C11.1, C12.1, C13.1, C14.1, C15.2, D5.1 (K), J3.6 (GND), R10.1, U2.2 (GND), U2.8 (S), U3.10 (VSS), U4.3 (GND), U4.5 (GND), U4.21 (GND), Y1.2, Y2.2
GNDS: C2.2, C3.2, C4.1, C5.1, C6.1, C7.2, D2.1 (A1), D3.1 (K), D4.2 (A), J1.1, R7.2, R8.2, R9.2, R10.2, U1.9 (GND), U1.11 (PwPd)
unnamed: C5.2, R6.1
unnamed: D1.2 (A), J1.2
unnamed: D3.2 (A), R3.2
unnamed: D5.2 (A), R15.1
unnamed: J1.3, R1.1
unnamed: J2.1, R11.1
unnamed: R2.2, R5.1
unnamed: C1.1, U1.1 (BOOT)
unnamed: C6.2, R6.2, U1.8 (COMP)
unnamed: R4.2, R7.1, U1.3 (EN)
unnamed: R8.1, U1.5 (RT/CLK)
unnamed: C4.2, U1.4 (SS/TR)
unnamed: U2.4 (RXD), U3.2 (RXCAN)
unnamed: U2.1 (TXD), U3.1 (TXCAN)
unnamed: U3.9 (OSC1), Y2.3
unnamed: U3.8 (OSC2), Y2.1
unnamed: R12.2, U3.19 (~RESET)
unnamed: C9.2, U4.20 (AREF)
unnamed: TP3.1, U4.12 (PB0)
unnamed: TP2.1, U4.13 (PB1)
unnamed: U4.7 (XTAL1/PB6), Y1.3
unnamed: U4.8 (XTAL2/PB7), Y1.1

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
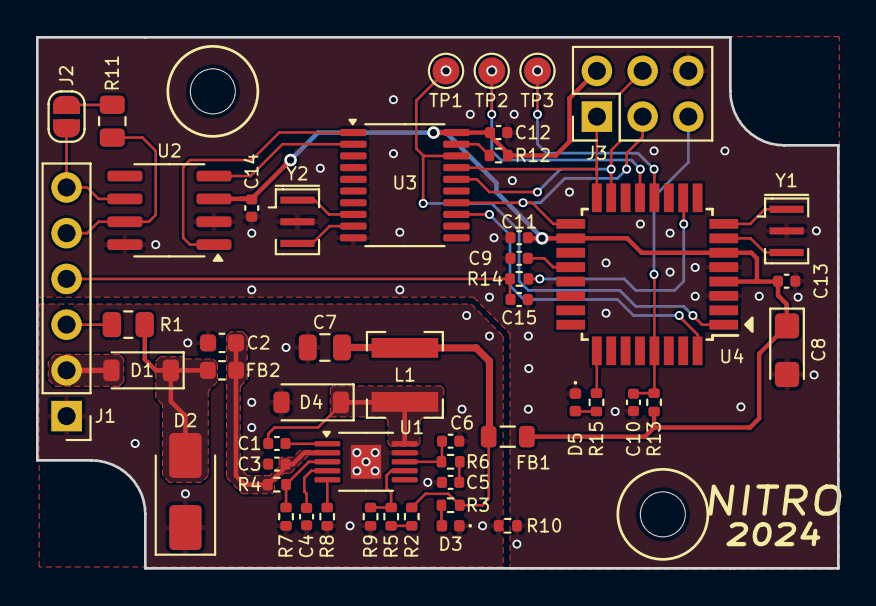
[picture p18: board Arduino_Emulator.kicad_pcb from above]

Board: 2 copper layers, 44.5 x 29.5 mm, 52 parts (0 on the bottom side), 41 nets.
