Nitro-Mekatronik/Emulators_2024/Firmware/STM32F103/BLE_K_Line_Analyzer/Core/Src/main.c

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
/* Includes ------------------------------------------------------------------*/
#include "main.h"

/* USER CODE BEGIN Includes */
#include "EEPROM.h"
#include "License.h"
#include "SerialFIFO.h"
#include "SerialProtocol.h"
#include "SmartLED.h"
#include <string.h>
/* USER CODE END Includes */

/* USER CODE BEGIN PTD */
extern int8_t LicenseStatus;
/* USER CODE END PTD */

/* USER CODE BEGIN PM */
#define BUZZER_ON() TIM3->CCR1 = 250
#define BUZZER_OFF() TIM3->CCR1 = 0

uint8_t beepCounter = 0;
/* USER CODE END PM */

ADC_HandleTypeDef hadc1;

CAN_HandleTypeDef hcan;

CRC_HandleTypeDef hcrc;

I2C_HandleTypeDef hi2c1;

SPI_HandleTypeDef hspi1;

TIM_HandleTypeDef htim3;
TIM_HandleTypeDef htim4;

UART_HandleTypeDef huart1;
UART_HandleTypeDef huart3;
DMA_HandleTypeDef hdma_usart1_rx;
DMA_HandleTypeDef hdma_usart3_rx;

void SystemClock_Config(void);
static void MX_GPIO_Init(void);
static void MX_DMA_Init(void);
static void MX_ADC1_Init(void);
static void MX_CAN_Init(void);
static void MX_CRC_Init(void);
static void MX_I2C1_Init(void);
static void MX_SPI1_Init(void);
static void MX_TIM3_Init(void);
static void MX_TIM4_Init(void);
static void MX_USART1_UART_Init(void);
static void MX_USART3_UART_Init(void);
/* USER CODE BEGIN PFP */

void LED_Red_Callback(bool status)
{
    if (TIM3->CCR1 == 250)
    {
        BUZZER_OFF(); // Buzzer Turn off
    }
    else
    {
        if (status == true)
        {
            if (++beepCounter >= 5)
            {
                beepCounter = 0;
                BUZZER_ON(); // Buzzer Turn on
            }
        }
    }
}

void LED_Green_Callback(bool status)
{
    // Future functionality for green LED can be added here
}

void LED_Blue_Callback(bool status)
{
    // Future functionality for blue LED can be added here
}

/* USER CODE END PFP */

/**
 * @brief  The application entry point.
 * @retval int
 */
int main(void)
{
    /* MCU Configuration--------------------------------------------------------*/

    /* Reset of all peripherals, Initializes the Flash interface and the Systick. */
    HAL_Init();

    /* Configure the system clock */
    SystemClock_Config();

    /* Initialize all configured peripherals */
    MX_GPIO_Init();
    MX_DMA_Init();
    MX_ADC1_Init();
    MX_CAN_Init();
    MX_CRC_Init();
    MX_I2C1_Init();
    MX_SPI1_Init();
    MX_TIM3_Init();
    MX_TIM4_Init();
    MX_USART1_UART_Init();
    MX_USART3_UART_Init();
    /* USER CODE BEGIN 2 */
    HAL_TIM_PWM_Start(&htim3, TIM_CHANNEL_1);

    UART1_Init();

    if (EEPROM_Init(AT24C32) != HAL_OK)
    {
        Error_Handler(); // Handle initialization failure
    }

    SmartLED_Init(LED_R_GPIO_Port, LED_R_Pin, true, &LED_Red_Callback);
    SmartLED_Init(LED_G_GPIO_Port, LED_G_Pin, true, &LED_Green_Callback);
    SmartLED_Init(LED_B_GPIO_Port, LED_B_Pin, true, &LED_Blue_Callback);

    if (Check_License() == VALID)
    {
        UART3_Init();
        SmartLED_SetMode(LED_G, LED_MODE_BLINK_SLOW);
    }
    else
    {
        SmartLED_SetMode(LED_R, LED_MODE_BLINK_SLOW);
        beepCounter = 5;
    }

    HAL_GPIO_WritePin(BLE_nRST_GPIO_Port, BLE_nRST_Pin, GPIO_PIN_SET);
    // Set high level to wake up the Module
    HAL_GPIO_WritePin(BLE_AT_MODE_GPIO_Port, BLE_AT_MODE_Pin, GPIO_PIN_SET);

    uint32_t startTime = HAL_GetTick(); // Get the start time

    // Wait for connection or timeout
    while (HAL_GPIO_ReadPin(BLE_STATUS_GPIO_Port, BLE_STATUS_Pin) == GPIO_PIN_RESET)
    {
        if ((HAL_GetTick() - startTime) > 20000)
        {
            // Timeout occurred, reset the BLE module
            HAL_GPIO_WritePin(BLE_nRST_GPIO_Port, BLE_nRST_Pin, GPIO_PIN_RESET);
            HAL_Delay(10);
            HAL_GPIO_WritePin(BLE_nRST_GPIO_Port, BLE_nRST_Pin, GPIO_PIN_SET);

            // Reset the start time and continue to wait for connection
            startTime = HAL_GetTick();
        }
    }

    // Set low level to enable AT command (just when BLE connected)
    HAL_GPIO_WritePin(BLE_AT_MODE_GPIO_Port, BLE_AT_MODE_Pin, GPIO_PIN_RESET);

    HAL_Delay(20);

    UART1_WriteStr("AT+NAMESmart Emulator\r\n"); // Set Bluetooth device name
    HAL_Delay(100);

    UART1_WriteStr("AT+STARTEN1\r\n"); // 1 = Start Wake up
    HAL_Delay(50);

    UART1_WriteStr("AT+ADVIN0\r\n"); // 0 = 100ms
    HAL_Delay(50);

    UART1_WriteStr("AT+MTU2\r\n"); // 2 = 128 bytes

    HAL_GPIO_WritePin(BLE_nRST_GPIO_Port, BLE_nRST_Pin, GPIO_PIN_SET);
    // Set high level to wake up the Module
    HAL_GPIO_WritePin(BLE_AT_MODE_GPIO_Port, BLE_AT_MODE_Pin, GPIO_PIN_SET);

    /* USER CODE END 2 */

    /* Infinite loop */
    /* USER CODE BEGIN WHILE */
    while (1)
    {
        uint16_t len = UART1_Available();
        while (len--)
        {
            uint8_t c = UART1_Read();
            UART3_Write(c);
        }

        len = UART3_Available();
        while (len--)
        {
            uint8_t c = UART3_Read();
            UART1_Write(c);
        }

        HAL_Delay(100);
        /* USER CODE END WHILE */

        /* USER CODE BEGIN 3 */
    }
    /* USER CODE END 3 */
}

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
/* USER CODE BEGIN 4 */
void deinitEverything(void)
{
    //-- reset peripherals to guarantee flawless start of user application
    HAL_GPIO_DeInit(LED_R_GPIO_Port, LED_R_Pin);
    HAL_GPIO_DeInit(LED_G_GPIO_Port, LED_G_Pin);
    HAL_GPIO_DeInit(LED_B_GPIO_Port, LED_B_Pin);
    HAL_ADC_MspDeInit(&hadc1);
    HAL_CAN_MspDeInit(&hcan);
    HAL_CRC_MspDeInit(&hcrc);
    HAL_I2C_MspDeInit(&hi2c1);
    HAL_SPI_MspDeInit(&hspi1);
    HAL_TIM_MspPostInit(&htim3);
    HAL_TIM_MspPostInit(&htim4);
    HAL_UART_MspDeInit(&huart1);
    HAL_UART_MspDeInit(&huart3);

    HAL_NVIC_DisableIRQ(DMA1_Channel3_IRQn);
    HAL_NVIC_DisableIRQ(DMA1_Channel5_IRQn);

    __HAL_RCC_GPIOC_CLK_DISABLE();
    __HAL_RCC_GPIOD_CLK_DISABLE();
    __HAL_RCC_GPIOB_CLK_DISABLE();
    __HAL_RCC_GPIOA_CLK_DISABLE();
    HAL_RCC_DeInit();
    HAL_DeInit();
    SysTick->CTRL = 0;
    SysTick->LOAD = 0;
    SysTick->VAL = 0;
}
/* USER CODE END 4 */
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
