Nitro-Mekatronik/Emulators_2024/Firmware/STM32F103/Template/BLE_UniEmulator_Template/BLE_UniEmulator_Template.ioc

Mcu.UserName=STM32F103CBTx
PA0-WKUP.Signal=ADCx_IN0
PA1.Signal=ADCx_IN1
PA10.Signal=USART1_RX
PA11.Signal=CAN_RX
PA12.Signal=CAN_TX
PA13.Signal=SYS_JTMS-SWDIO
PA14.Signal=SYS_JTCK-SWCLK
PA15.GPIO_Label=LED_B
PA15.Signal=GPIO_Output
PA2.Signal=ADCx_IN2
PA3.Signal=ADCx_IN3
PA4.Signal=SPI1_NSS
PA5.Signal=SPI1_SCK
PA6.Signal=SPI1_MISO
PA7.Signal=SPI1_MOSI
PA8.Signal=RCC_MCO
PA9.Signal=USART1_TX
PB0.Signal=GPXTI0
PB1.GPIO_Label=KLINE_MODE
PB1.Signal=GPIO_Output
PB10.Signal=USART3_TX
PB11.Signal=USART3_RX
PB12.GPIO_Label=DI1
PB12.Signal=GPIO_Input
PB13.GPIO_Label=DI2
PB13.Signal=GPIO_Input
PB14.GPIO_Label=DO1
PB14.Signal=GPIO_Output
PB15.GPIO_Label=DO2
PB15.Signal=GPIO_Output
PB3.GPIO_Label=LED_G
PB3.Signal=GPIO_Output
PB4.Signal=S_TIM3_CH1
PB5.GPIO_Label=LED_R
PB5.Signal=GPIO_Output
PB6.Signal=S_TIM4_CH1
PB7.Signal=S_TIM4_CH2
PB8.Signal=I2C1_SCL
PB9.Signal=I2C1_SDA
PC13-TAMPER-RTC.GPIO_Label=BLE_STATUS
PC13-TAMPER-RTC.Signal=GPIO_Input
PC14-OSC32_IN.GPIO_Label=BLE_nRST
PC14-OSC32_IN.Signal=GPIO_Output
PC15-OSC32_OUT.GPIO_Label=BLE_AT_MODE
PC15-OSC32_OUT.Signal=GPIO_Output
PD0-OSC_IN.Signal=RCC_OSC_IN
PD1-OSC_OUT.Signal=RCC_OSC_OUT
