Nitro-Mekatronik/Emulators_2024/Firmware/STM32F103/BLE_K_Line_Analyzer/Core/Inc/main.h

#define BLE_STATUS_Pin GPIO_PIN_13
#define BLE_STATUS_GPIO_Port GPIOC
#define BLE_nRST_Pin GPIO_PIN_14
#define BLE_nRST_GPIO_Port GPIOC
#define BLE_AT_MODE_Pin GPIO_PIN_15
#define BLE_AT_MODE_GPIO_Port GPIOC
#define KLINE_MODE_Pin GPIO_PIN_1
#define KLINE_MODE_GPIO_Port GPIOB
#define DI1_Pin GPIO_PIN_12
#define DI1_GPIO_Port GPIOB
#define DI2_Pin GPIO_PIN_13
#define DI2_GPIO_Port GPIOB
#define DO1_Pin GPIO_PIN_14
#define DO1_GPIO_Port GPIOB
#define DO2_Pin GPIO_PIN_15
#define DO2_GPIO_Port GPIOB
#define LED_B_Pin GPIO_PIN_15
#define LED_B_GPIO_Port GPIOA
#define LED_G_Pin GPIO_PIN_3
#define LED_G_GPIO_Port GPIOB
#define LED_R_Pin GPIO_PIN_5
#define LED_R_GPIO_Port GPIOB
