Nitro-Mekatronik/Emulators_2024/(commit log)

2024-02-26 add HW FW and Boot
    [Bluetooth.kicad_sch, CAN.BUS_DRIVER.kicad_sch, Emulator.ods, K_LINE_Driver.kicad_sch, NTR-MAIN-U2xx.kicad_pcb, NTR-MAIN-U2xx.kicad_sch, Power.kicad_sch, bom.csv]
2024-03-15 update SerialFIFO & Device Info
    [VOLVO s60 ELV.xlsx, bmw E90.ods, volvo S60.xlsx]
2024-03-15 add shield number in device info res
2024-04-15 add V40 and arduino HW
    [Arduino_Emulator.kicad_pcb, Arduino_Emulator.kicad_sch, Arduino_Emulator.sch, Arduino_Emulator.xlsm, VOLVO s60 ELV.xlsx, bmw E90.ods, bom.csv, designators.csv]
2024-08-20 update bootloader
    [NTR-MAIN-U2xx.kicad_sch]
2024-09-03 BMW Parity Bug
    [designators.csv]
2024-09-24 update boot and app
    [Bluetooth.kicad_sch, CAN.BUS_DRIVER.kicad_sch, K_LINE_Driver.kicad_sch, NTR-MAIN-U2xx.kicad_pcb, Power.kicad_sch, VOLVO s60 ELV.xlsx, bmw E90.ods, bom.csv]
2024-09-25 fix bug Boot BLE Disable
    [BLE_UniEmulator_Bootloader.ioc, main.c]
2024-09-25 fix bug in startup BLE Reset
    [BLE_UniEmulator_Template.ioc, main.c]
2025-08-07 Initial commit: Project setup with documentation and basic structure
    [Arduino_Emulator.kicad_pcb, Arduino_Emulator.kicad_sch, Arduino_Emulator.sch, Arduino_Emulator.xlsm, Bluetooth.kicad_sch, CAN.BUS_DRIVER.kicad_sch, K_LINE_Driver.kicad_sch, NTR-MAIN-U2xx.kicad_pcb]
