Nitro-Mekatronik/Emulators_2024/(notices)

Notices in the files:
Firmware/STM32F103/Emulators/ESL/BLE_UniEmulator_Volvo_V40/Core/Inc/main.h:
Copyright (c) 2023 STMicroelectronics.
All rights reserved.
This software is licensed under terms that can be found in the LICENSE file
